avenqo/otto-robot/20_hardware/3D/LP-Abstandshalter.3mf

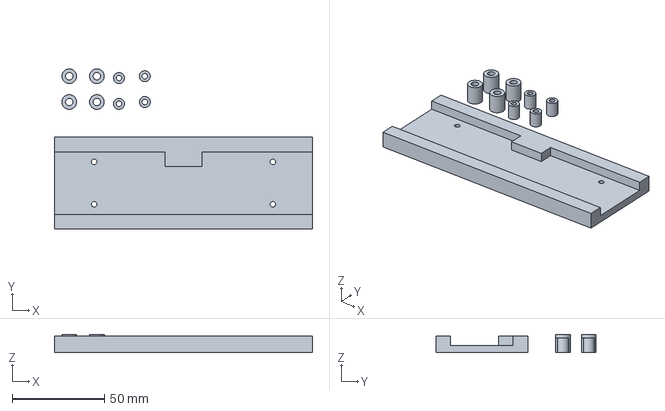
[picture p1: CAD file, 2026-10-09]
20_hardware/3D/LP-Abstandshalter.3mf
140.0 x 87.0 x 10.0 mm
