avenqo/otto-robot/20_hardware/3D/wheel.stl

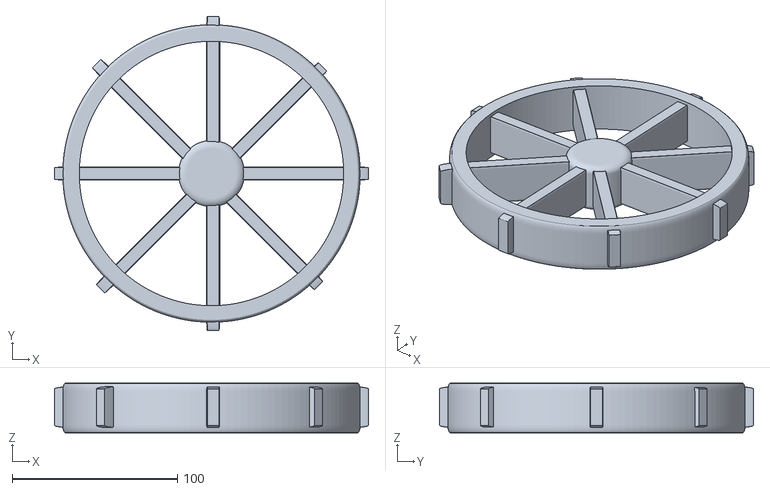
[picture p2: CAD file, 2026-10-09]
20_hardware/3D/wheel.stl
190.0 x 190.0 x 30.0
