avenqo/otto-robot/(list of files, cad)

Other CAD files:
20_hardware/3D/LP-Abstandshalter.stl
